psp-player/Voice-Controlled_Robot_Arm/latex/main_8c.tex

\doxysection{main.\+c File Reference}
\hypertarget{main_8c}{}\label{main_8c}\index{main.c@{main.c}}

:\+ Minimal TIM2\+\_\+\+CH1 PWM test — PA0 only  

{\ttfamily \+\#include "{}main.\+h"{}}\newline
{\ttfamily \+\#include "{}usb\+\_\+device.\+h"{}}\newline
{\ttfamily \+\#include "{}arm\+\_\+control.\+h"{}}\newline
{\ttfamily \+\#include "{}usbd\+\_\+cdc\+\_\+if.\+h"{}}\newline
{\ttfamily \+\#include $<$stdio.\+h$>$}\newline
{\ttfamily \+\#include $<$string.\+h$>$}\newline
\doxysubsubsection*{Functions}
\begin{DoxyCompactItemize}
\item 
void \doxymbox{\hyperlink{main_8c_a70af21c671abfcc773614a9a4f63d920}{System\+Clock\+\_\+\+Config}} (void)
\begin{DoxyCompactList}\small\item\em System Clock Configuration. \end{DoxyCompactList}\item 
int \doxymbox{\hyperlink{main_8c_a840291bc02cba5474a4cb46a9b9566fe}{main}} (void)
\begin{DoxyCompactList}\small\item\em The application entry point. \end{DoxyCompactList}\item 
void \doxymbox{\hyperlink{main_8c_a1730ffe1e560465665eb47d9264826f9}{Error\+\_\+\+Handler}} (void)
\begin{DoxyCompactList}\small\item\em This function is executed in case of error occurrence. \end{DoxyCompactList}\end{DoxyCompactItemize}
\doxysubsubsection*{Variables}
\begin{DoxyCompactItemize}
\item 
\Hypertarget{main_8c_a903f142e0e6a1530453708ece712ae2b}\label{main_8c_a903f142e0e6a1530453708ece712ae2b} 
DFSDM\+\_\+\+Filter\+\_\+\+Handle\+Type\+Def {\bfseries hdfsdm1\+\_\+filter0}
\item 
\Hypertarget{main_8c_a9bb0868d234e6b0841783572c64fb8c2}\label{main_8c_a9bb0868d234e6b0841783572c64fb8c2} 
DFSDM\+\_\+\+Channel\+\_\+\+Handle\+Type\+Def {\bfseries hdfsdm1\+\_\+channel1}
\item 
\Hypertarget{main_8c_a2f435f59b711a502f84aed90223b824d}\label{main_8c_a2f435f59b711a502f84aed90223b824d} 
DMA\+\_\+\+Handle\+Type\+Def {\bfseries hdma\+\_\+dfsdm1\+\_\+flt0}
\item 
\Hypertarget{main_8c_a9c6222bae4d0328dd843ae099623b40b}\label{main_8c_a9c6222bae4d0328dd843ae099623b40b} 
SPI\+\_\+\+Handle\+Type\+Def {\bfseries hspi1}
\item 
\Hypertarget{main_8c_a25fc663547539bc49fecc0011bd76ab5}\label{main_8c_a25fc663547539bc49fecc0011bd76ab5} 
TIM\+\_\+\+Handle\+Type\+Def {\bfseries htim1}
\item 
\Hypertarget{main_8c_a2c80fd5510e2990a59a5c90d745c716c}\label{main_8c_a2c80fd5510e2990a59a5c90d745c716c} 
TIM\+\_\+\+Handle\+Type\+Def {\bfseries htim2}
\item 
\Hypertarget{main_8c_aac3d2c59ee0e3bbae1b99529a154eb62}\label{main_8c_aac3d2c59ee0e3bbae1b99529a154eb62} 
TIM\+\_\+\+Handle\+Type\+Def {\bfseries htim3}
\item 
\Hypertarget{main_8c_a85788cec5a97ee377e4ee2e74f026484}\label{main_8c_a85788cec5a97ee377e4ee2e74f026484} 
TIM\+\_\+\+Handle\+Type\+Def {\bfseries htim4}
\item 
\Hypertarget{main_8c_a73ecb17475b6b09997fcb3a6fb9fbeb6}\label{main_8c_a73ecb17475b6b09997fcb3a6fb9fbeb6} 
volatile uint8\+\_\+t {\bfseries cmd\+\_\+ready} = 0
\item 
\Hypertarget{main_8c_aa4f391c9ea24b6f9afb68ad06e13dbba}\label{main_8c_aa4f391c9ea24b6f9afb68ad06e13dbba} 
volatile char {\bfseries cmd\+\_\+buf} \+[64]\+
\end{DoxyCompactItemize}

\doxysubsection{Detailed Description}
:\+ Minimal TIM2\+\_\+\+CH1 PWM test — PA0 only 

\label{main_8c_doc-func-members}
\Hypertarget{main_8c_doc-func-members}
\doxysubsection{Function Documentation}
\Hypertarget{main_8c_a1730ffe1e560465665eb47d9264826f9}\index{main.c@{main.c}!Error\_Handler@{Error\_Handler}}
\index{Error\_Handler@{Error\_Handler}!main.c@{main.c}}
\doxysubsubsection{\texorpdfstring{Error\_Handler()}{Error\_Handler()}}
{\footnotesize\ttfamily \label{main_8c_a1730ffe1e560465665eb47d9264826f9} 
void Error\+\_\+\+Handler (\begin{DoxyParamCaption}\item[{void}]{}{}\end{DoxyParamCaption})}

This function is executed in case of error occurrence. 

\begin{DoxyRetVals}{Return values}
{\em None} & \\
\hline
\end{DoxyRetVals}
\Hypertarget{main_8c_a840291bc02cba5474a4cb46a9b9566fe}\index{main.c@{main.c}!main@{main}}
\index{main@{main}!main.c@{main.c}}
\doxysubsubsection{\texorpdfstring{main()}{main()}}
{\footnotesize\ttfamily \label{main_8c_a840291bc02cba5474a4cb46a9b9566fe} 
int main (\begin{DoxyParamCaption}\item[{void}]{}{}\end{DoxyParamCaption})}

The application entry point. 

\begin{DoxyRetVals}{Return values}
{\em int} & \\
\hline
\end{DoxyRetVals}
\Hypertarget{main_8c_a70af21c671abfcc773614a9a4f63d920}\index{main.c@{main.c}!SystemClock\_Config@{SystemClock\_Config}}
\index{SystemClock\_Config@{SystemClock\_Config}!main.c@{main.c}}
\doxysubsubsection{\texorpdfstring{SystemClock\_Config()}{SystemClock\_Config()}}
{\footnotesize\ttfamily \label{main_8c_a70af21c671abfcc773614a9a4f63d920} 
void System\+Clock\+\_\+\+Config (\begin{DoxyParamCaption}\item[{void}]{}{}\end{DoxyParamCaption})}

System Clock Configuration. 

\begin{DoxyRetVals}{Return values}
{\em None} & \\
\hline
\end{DoxyRetVals}
Configure the main internal regulator output voltage

Initializes the RCC Oscillators according to the specified parameters in the RCC\+\_\+\+Osc\+Init\+Type\+Def structure.

Initializes the CPU, AHB and APB buses clocks

Enable the SYSCFG APB clock

Configures CRS
