psp-player/Voice-Controlled_Robot_Arm/latex/topics.tex

\doxysection{Topics}
Here is a list of all topics with brief descriptions:\+\begin{DoxyCompactList}
\item \contentsline{section}{STM32\+\_\+\+USB\+\_\+\+OTG\+\_\+\+DEVICE\+\_\+\+LIBRARY }{\pageref{group___s_t_m32___u_s_b___o_t_g___d_e_v_i_c_e___l_i_b_r_a_r_y}}{}
\begin{DoxyCompactList}
\item \contentsline{section}{USBD\+\_\+\+CDC\+\_\+\+IF }{\pageref{group___u_s_b_d___c_d_c___i_f}}{}
\begin{DoxyCompactList}
\item \contentsline{section}{USBD\+\_\+\+CDC\+\_\+\+IF\+\_\+\+Private\+\_\+\+Types\+Definitions }{\pageref{group___u_s_b_d___c_d_c___i_f___private___types_definitions}}{}
\item \contentsline{section}{USBD\+\_\+\+CDC\+\_\+\+IF\+\_\+\+Private\+\_\+\+Defines }{\pageref{group___u_s_b_d___c_d_c___i_f___private___defines}}{}
\item \contentsline{section}{USBD\+\_\+\+CDC\+\_\+\+IF\+\_\+\+Private\+\_\+\+Macros }{\pageref{group___u_s_b_d___c_d_c___i_f___private___macros}}{}
\item \contentsline{section}{USBD\+\_\+\+CDC\+\_\+\+IF\+\_\+\+Private\+\_\+\+Variables }{\pageref{group___u_s_b_d___c_d_c___i_f___private___variables}}{}
\item \contentsline{section}{USBD\+\_\+\+CDC\+\_\+\+IF\+\_\+\+Exported\+\_\+\+Variables }{\pageref{group___u_s_b_d___c_d_c___i_f___exported___variables}}{}
\item \contentsline{section}{USBD\+\_\+\+CDC\+\_\+\+IF\+\_\+\+Private\+\_\+\+Function\+Prototypes }{\pageref{group___u_s_b_d___c_d_c___i_f___private___function_prototypes}}{}
\item \contentsline{section}{USBD\+\_\+\+CDC\+\_\+\+IF\+\_\+\+Exported\+\_\+\+Defines }{\pageref{group___u_s_b_d___c_d_c___i_f___exported___defines}}{}
\item \contentsline{section}{USBD\+\_\+\+CDC\+\_\+\+IF\+\_\+\+Exported\+\_\+\+Types }{\pageref{group___u_s_b_d___c_d_c___i_f___exported___types}}{}
\item \contentsline{section}{USBD\+\_\+\+CDC\+\_\+\+IF\+\_\+\+Exported\+\_\+\+Macros }{\pageref{group___u_s_b_d___c_d_c___i_f___exported___macros}}{}
\item \contentsline{section}{USBD\+\_\+\+CDC\+\_\+\+IF\+\_\+\+Exported\+\_\+\+Functions\+Prototype }{\pageref{group___u_s_b_d___c_d_c___i_f___exported___functions_prototype}}{}
\end{DoxyCompactList}
\end{DoxyCompactList}
\end{DoxyCompactList}
