psp-player/Voice-Controlled_Robot_Arm/latex/usbd__cdc__if_8c.tex

\doxysection{usbd\+\_\+cdc\+\_\+if.\+c File Reference}
\hypertarget{usbd__cdc__if_8c}{}\label{usbd__cdc__if_8c}\index{usbd\_cdc\_if.c@{usbd\_cdc\_if.c}}

:\+ Usb device for Virtual Com Port.  

{\ttfamily \+\#include "{}usbd\+\_\+cdc\+\_\+if.\+h"{}}\newline
\doxysubsubsection*{Functions}
\begin{DoxyCompactItemize}
\item 
uint8\+\_\+t \doxymbox{\hyperlink{group___u_s_b_d___c_d_c___i_f_ga5137d6201dbdef2bf351c5b4941c24f4}{CDC\+\_\+\+Transmit\+\_\+\+FS}} (uint8\+\_\+t \texorpdfstring{$\ast$}{*}Buf, uint16\+\_\+t Len)
\begin{DoxyCompactList}\small\item\em CDC\+\_\+\+Transmit\+\_\+\+FS Data to send over USB IN endpoint are sent over CDC interface through this function. \end{DoxyCompactList}\end{DoxyCompactItemize}
\doxysubsubsection*{Variables}
\begin{DoxyCompactItemize}
\item 
uint8\+\_\+t \doxymbox{\hyperlink{group___u_s_b_d___c_d_c___i_f___private___variables_ga1e37e6616e6affe5acf9c0befd063f6a}{User\+Rx\+Buffer\+FS}} \+[APP\+\_\+\+RX\+\_\+\+DATA\+\_\+\+SIZE]\+
\item 
uint8\+\_\+t \doxymbox{\hyperlink{group___u_s_b_d___c_d_c___i_f___private___variables_gad48fea85cdb7aed49bf62140a52f23e0}{User\+Tx\+Buffer\+FS}} \+[APP\+\_\+\+TX\+\_\+\+DATA\+\_\+\+SIZE]\+
\item 
USBD\+\_\+\+Handle\+Type\+Def {\bfseries h\+Usb\+Device\+FS}
\item 
USBD\+\_\+\+CDC\+\_\+\+Itf\+Type\+Def \doxymbox{\hyperlink{group___u_s_b_d___c_d_c___i_f_ga99394ed19b774f171df96c2848c411ed}{USBD\+\_\+\+Interface\+\_\+fops\+\_\+\+FS}}
\end{DoxyCompactItemize}

\doxysubsection{Detailed Description}
:\+ Usb device for Virtual Com Port. 

\begin{DoxyVersion}{Version}
:\+ v2.\+0\+\_\+\+Cube 
\end{DoxyVersion}
\begin{DoxyAttention}{Attention}

\end{DoxyAttention}
Copyright (c) 2026 STMicroelectronics. All rights reserved.

This software is licensed under terms that can be found in the LICENSE file in the root directory of this software component. If no LICENSE file comes with this software, it is provided AS-\/\+IS.
