psp-player/Voice-Controlled_Robot_Arm/main.c

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
/* Includes ------------------------------------------------------------------*/
#include "main.h"
#include "usb_device.h"

/* USER CODE BEGIN Includes */
#include "arm_control.h"
#include "usbd_cdc_if.h"    /* for CDC_Transmit_FS */
#include <stdio.h>
#include <string.h>

/* USER CODE END Includes */

DFSDM_Filter_HandleTypeDef hdfsdm1_filter0;
DFSDM_Channel_HandleTypeDef hdfsdm1_channel1;
DMA_HandleTypeDef hdma_dfsdm1_flt0;

SPI_HandleTypeDef hspi1;

TIM_HandleTypeDef htim1;
TIM_HandleTypeDef htim2;
TIM_HandleTypeDef htim3;
TIM_HandleTypeDef htim4;

/* USER CODE BEGIN PV */
volatile uint8_t cmd_ready = 0;   /**< Set by the USB CDC RX callback when a full command line is buffered. */
volatile char    cmd_buf[64];     /**< Latest received ASCII command line. */
/* USER CODE END PV */

void SystemClock_Config(void);
static void MX_GPIO_Init(void);
static void MX_DMA_Init(void);
static void MX_DFSDM1_Init(void);
static void MX_SPI1_Init(void);
static void MX_TIM1_Init(void);
static void MX_TIM2_Init(void);
static void MX_TIM3_Init(void);
static void MX_TIM4_Init(void);
/**
  * @brief  The application entry point.
  * @retval int
  */
int main(void)
{

  /* MCU Configuration--------------------------------------------------------*/

  /* Reset of all peripherals, Initializes the Flash interface and the Systick. */
  HAL_Init();

  /* Configure the system clock */
  SystemClock_Config();

  /* Initialize all configured peripherals */
  MX_GPIO_Init();
  MX_DMA_Init();
  MX_DFSDM1_Init();
  MX_SPI1_Init();
  MX_TIM1_Init();
  MX_TIM2_Init();
  MX_TIM3_Init();
  MX_TIM4_Init();
  MX_USB_DEVICE_Init();
  /* USER CODE BEGIN 2 */
    arm_init();
    gripper_init();

    uint8_t  drv_ok = arm_drivers_init();
    uint32_t ioin0  = arm_dbg_ioin(0);
    (void)drv_ok; (void)ioin0;     /* step PAST this line, THEN read both */                      /* break here first: bit 0 must be set, else motor 1 isn't enabled */
//    float fx, fy, fz;
//    arm_fk(0.0f, 1.5707963f, -1.5707963f, &fx, &fy, &fz);   /* +pi/2, -pi/2 */
//    (void)fx; (void)fy; (void)fz;   /* expect fx≈245, fy≈0, fz≈315 <- home position */

      /* test ONE joint, small move, watch which way it goes */
//      arm_test_spin(2, +1, 800, 400.0f);   /* shoulder: +1 should LIFT the upper arm */
//    	arm_move_to(0, 245, 315, 1);
//    arm_move_to(300, 0, 200, 1);
//      while (arm_is_moving()) { }
  /* USER CODE END 2 */

  /* Infinite loop */
  /* USER CODE BEGIN WHILE */
  /**
   * @brief Main command loop.
   *
   * Polls ::cmd_ready and dispatches one ASCII command per line:
   *   - "M,<color>,<x>,<y>,<z>" : solve IK, move to (x,y,z), close gripper on arrival
   *   - "GRIP,OPEN" / "GRIP,CLOSE" : actuate the gripper
   *   - "WHERE" : reply "POS,x,y,z" from forward kinematics
   * Replies "DONE" on success or "ERR" on an unreachable target / parse failure.
   */
      while (1)
      {
    	  if (cmd_ready) {
    	      cmd_ready = 0;

    	      if (strncmp((char*)cmd_buf, "GRIP,OPEN", 9) == 0) {
    	          gripper_open();
    	          HAL_Delay(500);
    	          CDC_Transmit_FS((uint8_t*)"DONE\n", 5);
    	      }
    	      else if (strncmp((char*)cmd_buf, "GRIP,CLOSE", 10) == 0) {
    	          gripper_close();
    	          HAL_Delay(500);
    	          CDC_Transmit_FS((uint8_t*)"DONE\n", 5);
    	      }
    	      else if (strncmp((char*)cmd_buf, "WHERE", 5) == 0) {
    	          float cx, cy, cz;
    	          arm_get_xyz(&cx, &cy, &cz);
    	          char out[48];
    	          int len = snprintf(out, sizeof(out), "POS,%.1f,%.1f,%.1f\n", cx, cy, cz);
    	          CDC_Transmit_FS((uint8_t*)out, len);
    	      }
    	      else {
    	          char color[16];
    	          float x, y, z;
    	          int n = sscanf((char*)cmd_buf, "M,%15[^,],%f,%f,%f", color, &x, &y, &z);
    	          if (n == 4) {
    	              if (!arm_is_moving() && arm_move_to(x, y, z, 1)) {
    	                  while (arm_is_moving()) { }
    	                  HAL_Delay(300);          /* settle */
    	                  gripper_close();         /* grab on arrival */
    	                  HAL_Delay(500);
    	                  CDC_Transmit_FS((uint8_t*)"DONE\n", 5);
    	              } else {
    	                  CDC_Transmit_FS((uint8_t*)"ERR\n", 4);
    	              }
    	          } else {
    	              CDC_Transmit_FS((uint8_t*)"ERR\n", 4);
    	          }
    	      }
    	  }
      }
  /* USER CODE END 3 */
}

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
