psp-player/Voice-Controlled_Robot_Arm/ME507_Final_Project.ioc

Mcu.UserName=STM32L4A6ZGTxP
PA0.Signal=S_TIM2_CH1
PA11.Signal=USB_OTG_FS_DM
PA12.Signal=USB_OTG_FS_DP
PA5.Signal=SPI1_SCK
PA6.Signal=SPI1_MISO
PA7.Signal=SPI1_MOSI
PA8.Signal=S_TIM1_CH1
PA9.Signal=USB_OTG_FS_VBUS
PB0.GPIO_Label=M1_CS
PB0.Signal=GPIO_Output
PB1.GPIO_Label=M2_CS
PB1.Signal=GPIO_Output
PB12.Signal=S_DATAIN1DFSDM1
PB2.GPIO_Label=M3_CS
PB2.Signal=GPIO_Output
PB7.Signal=S_TIM4_CH2
PC0.GPIO_Label=M1_DIAG0
PC0.Signal=GPXTI0
PC1.GPIO_Label=M2_DIAG0
PC1.Signal=GPXTI1
PC2.Signal=S_CKOUTDFSDM1
PC3.GPIO_Label=M1_DIAG1
PC3.Signal=GPIO_Input
PC4.GPIO_Label=M2_DIAG1
PC4.Signal=GPIO_Input
PC5.GPIO_Label=M3_DIAG1
PC5.Signal=GPIO_Input
PC6.Signal=S_TIM3_CH1
PD0.GPIO_Label=M3_DIAG0
PD0.Signal=GPIO_Input
PE10.GPIO_Label=M2_DIR
PE10.Signal=GPIO_Output
PE11.GPIO_Label=M3_DIR
PE11.Signal=GPIO_Output
PE12.GPIO_Label=M1_EN
PE12.Signal=GPIO_Output
PE13.GPIO_Label=M2_EN
PE13.Signal=GPIO_Output
PE14.GPIO_Label=M3_EN
PE14.Signal=GPIO_Output
PE9.GPIO_Label=M1_DIR
PE9.Signal=GPIO_Output
