psp-player/Voice-Controlled_Robot_Arm/main.h

#define M1_DIAG0_Pin GPIO_PIN_0
#define M1_DIAG0_GPIO_Port GPIOC
#define M1_DIAG0_EXTI_IRQn EXTI0_IRQn
#define M2_DIAG0_Pin GPIO_PIN_1
#define M2_DIAG0_GPIO_Port GPIOC
#define M2_DIAG0_EXTI_IRQn EXTI1_IRQn
#define M1_DIAG1_Pin GPIO_PIN_3
#define M1_DIAG1_GPIO_Port GPIOC
#define M2_DIAG1_Pin GPIO_PIN_4
#define M2_DIAG1_GPIO_Port GPIOC
#define M3_DIAG1_Pin GPIO_PIN_5
#define M3_DIAG1_GPIO_Port GPIOC
#define M1_CS_Pin GPIO_PIN_0
#define M1_CS_GPIO_Port GPIOB
#define M2_CS_Pin GPIO_PIN_1
#define M2_CS_GPIO_Port GPIOB
#define M3_CS_Pin GPIO_PIN_2
#define M3_CS_GPIO_Port GPIOB
#define M1_DIR_Pin GPIO_PIN_9
#define M1_DIR_GPIO_Port GPIOE
#define M2_DIR_Pin GPIO_PIN_10
#define M2_DIR_GPIO_Port GPIOE
#define M3_DIR_Pin GPIO_PIN_11
#define M3_DIR_GPIO_Port GPIOE
#define M1_EN_Pin GPIO_PIN_12
#define M1_EN_GPIO_Port GPIOE
#define M2_EN_Pin GPIO_PIN_13
#define M2_EN_GPIO_Port GPIOE
#define M3_EN_Pin GPIO_PIN_14
#define M3_EN_GPIO_Port GPIOE
#define M3_DIAG0_Pin GPIO_PIN_0
#define M3_DIAG0_GPIO_Port GPIOD
